jshumhl/Humane-Mousetrap/README.md

# Humane-Mousetrap
 EK 210 Engineering Product Design - Spring 2019 - Boston University

- Collaborated with 3 members, created a humane mousetrap from scratch with budget of $170
- WiFi connection via ESP8266 and interaction with Telegram Messenger via Telegram BOT
- East to customize mousetrap through Telegram Messenger application on their smartphones
- Notfications to users on mouse capture via Telegram Messenger
- Able to release mouse remotely through Telegram Messenger

Video Showcase: https://www.youtube.com/watch?v=E8XZEORb02s&feature=emb_logo
